kuna/museoncon/model/README.md

## Description

Those models only includes bottom parts and top parts. Other parts (body, scratch board) are reused from MuseOn controller.

### Original model URL
https://cad.onshape.com/documents/9d15ab35a640afc5610f11aa/w/20e474e34c52557906518db1/e/6f6ff2d6295136870e9082ac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
