kuna/museoncon/circuit/top.png

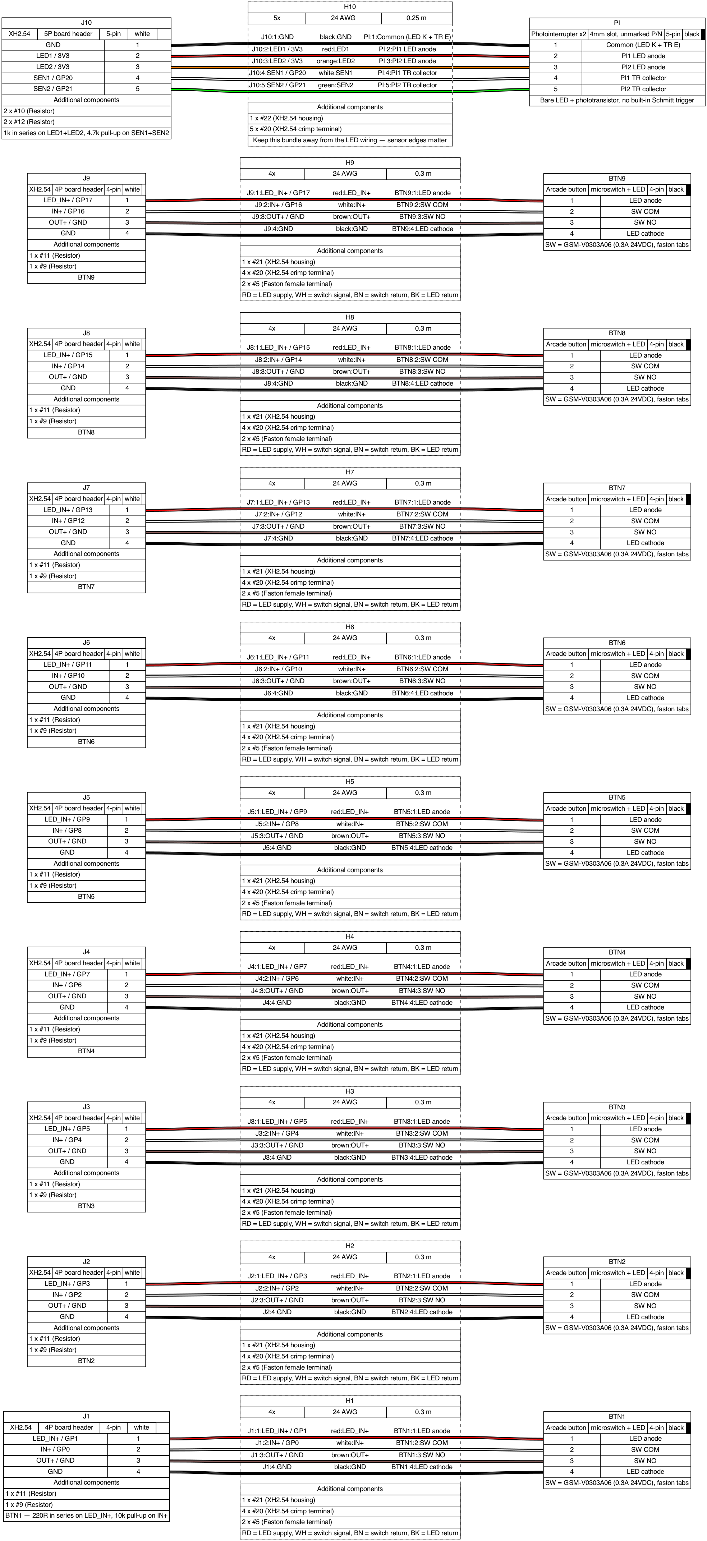
circuit/top.png
