kuna/museoncon/model/beatcon-btm-full.stl

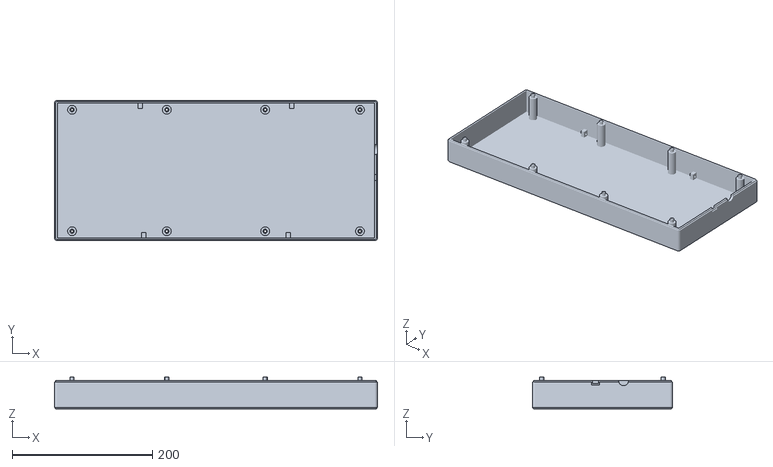
[picture p4: CAD file, 2026-10-25]
model/beatcon-btm-full.stl
460.0 x 200.0 x 45.0
