kuna/museoncon/model/beatcon-top.stl

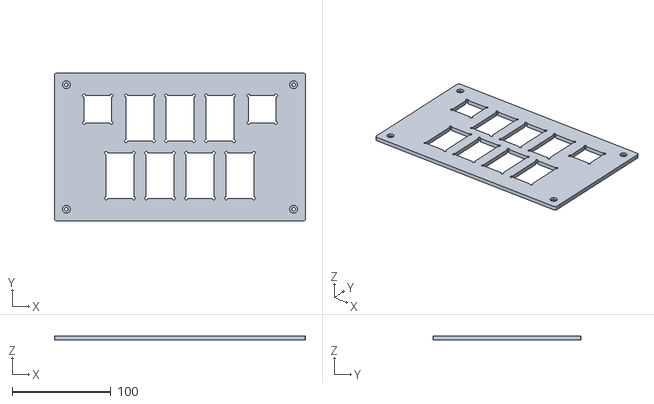
[picture p5: CAD file, 2026-10-25]
model/beatcon-top.stl
254.0 x 150.0 x 4.50
