kuna/museoncon/circuit/museon.kicad_pcb

## KiCad design circuit/museon.kicad_pcb (2026-10-25)

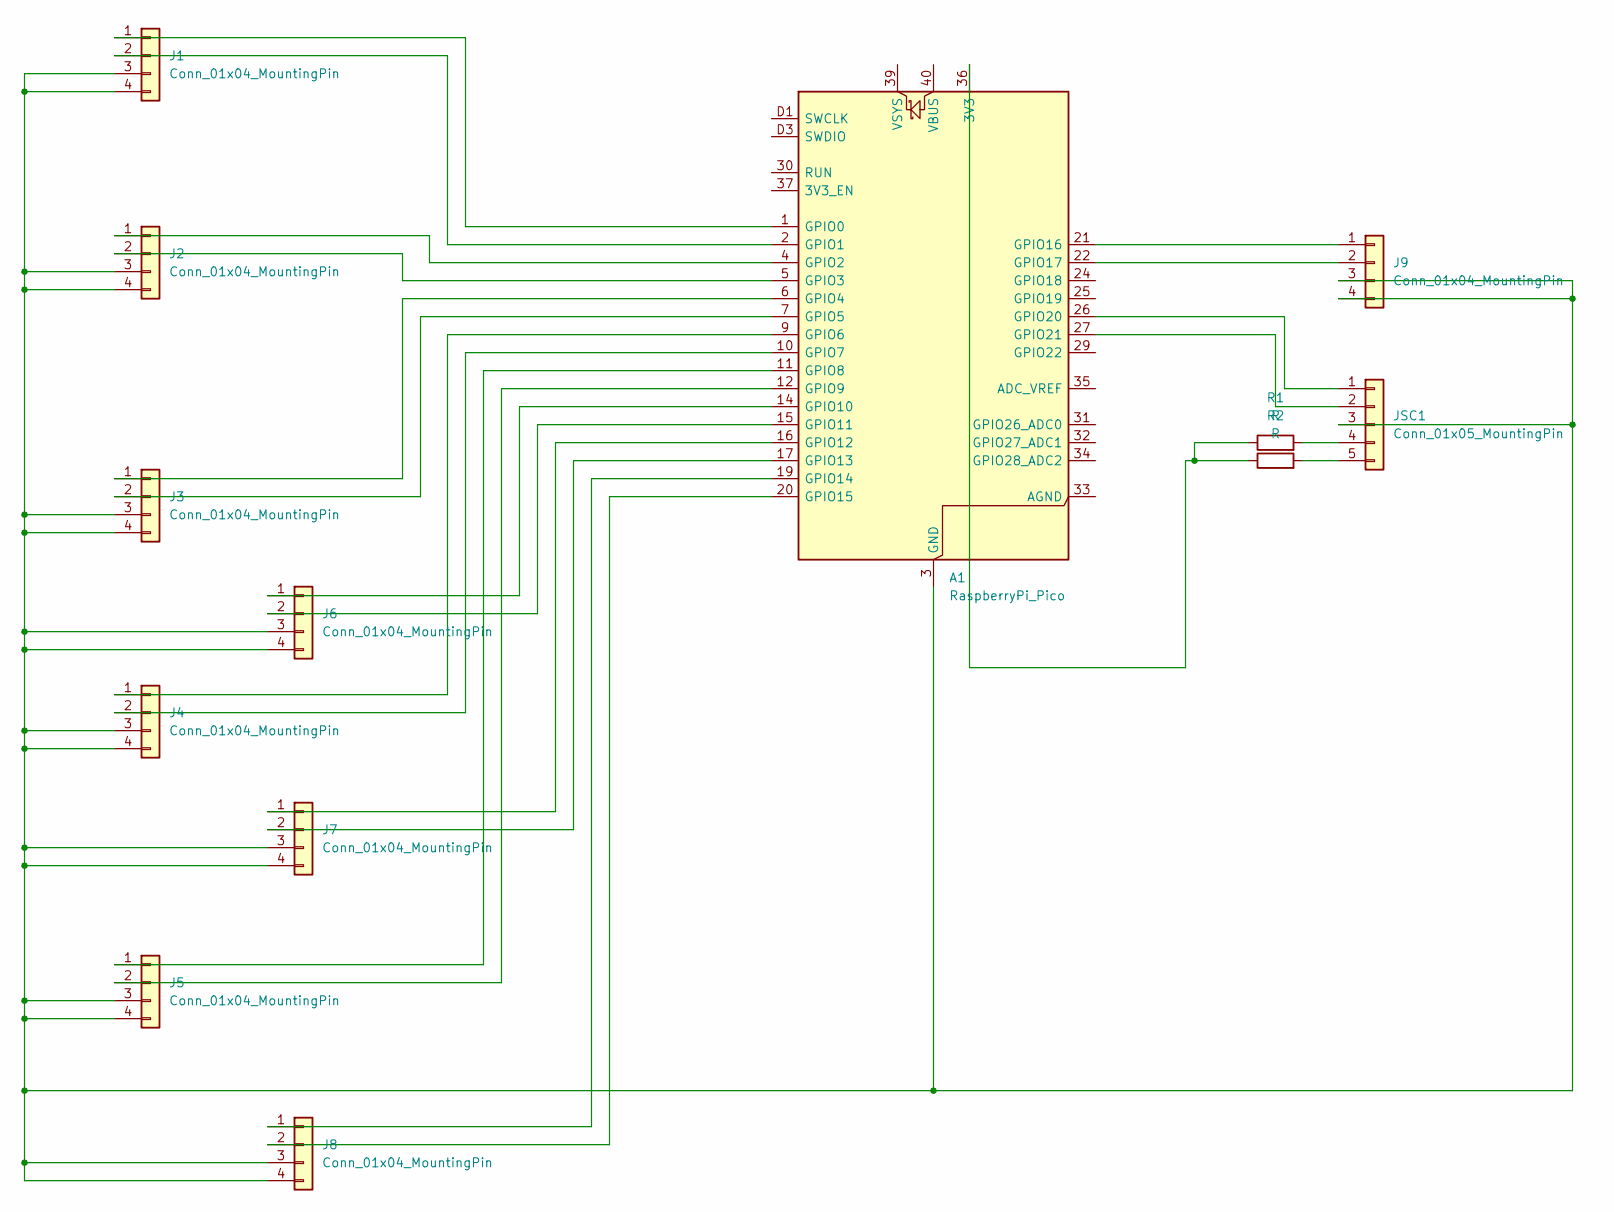
[picture p6: schematic museon.kicad_sch]

Parts:
A1: RaspberryPi_Pico; RaspberryPi_Pico_SMD_HandSolder
J1, J2, J3, J4, J5, J6, J7, J8, J9: Conn_01x04_MountingPin; JST_XH_B4B-XH-A_1x04_P2.50mm_Vertical
JSC1: Conn_01x05_MountingPin; JST_XH_B5B-XH-A_1x05_P2.50mm_Vertical
R1, R2: R; R_Axial_DIN0207_L6.3mm_D2.5mm_P7.62mm_Horizontal

Connections:
unnamed: A1.36 (3V3), R1.1, R2.1
unnamed: A1.1 (GPIO0), J1.1
unnamed: A1.2 (GPIO1), J1.2
unnamed: A1.4 (GPIO2), J2.1
unnamed: A1.5 (GPIO3), J2.2
unnamed: A1.6 (GPIO4), J3.1
unnamed: A1.7 (GPIO5), J3.2
unnamed: A1.9 (GPIO6), J4.1
unnamed: A1.10 (GPIO7), J4.2
unnamed: A1.11 (GPIO8), J5.1
unnamed: A1.12 (GPIO9), J5.2
unnamed: A1.14 (GPIO10), J6.1
unnamed: A1.15 (GPIO11), J6.2
unnamed: A1.16 (GPIO12), J7.1
unnamed: A1.17 (GPIO13), J7.2
unnamed: A1.19 (GPIO14), J8.1
unnamed: A1.20 (GPIO15), J8.2
unnamed: A1.21 (GPIO16), J9.1
unnamed: A1.22 (GPIO17), J9.2
unnamed: A1.26 (GPIO20), JSC1.1
unnamed: A1.27 (GPIO21), JSC1.2
unnamed: A1.3 (GND), A1.8 (GND), A1.13 (GND), A1.18 (GND), A1.23 (GND), A1.28 (GND), A1.38 (GND), A1.D2 (GND), J1.3, J1.4, J2.3, J2.4, J3.3, J3.4, J4.3, J4.4, J5.3, J5.4, J6.3, J6.4, J7.3, J7.4, J8.3, J8.4, J9.3, J9.4, JSC1.3
unnamed: JSC1.4, R1.2
unnamed: JSC1.5, R2.2

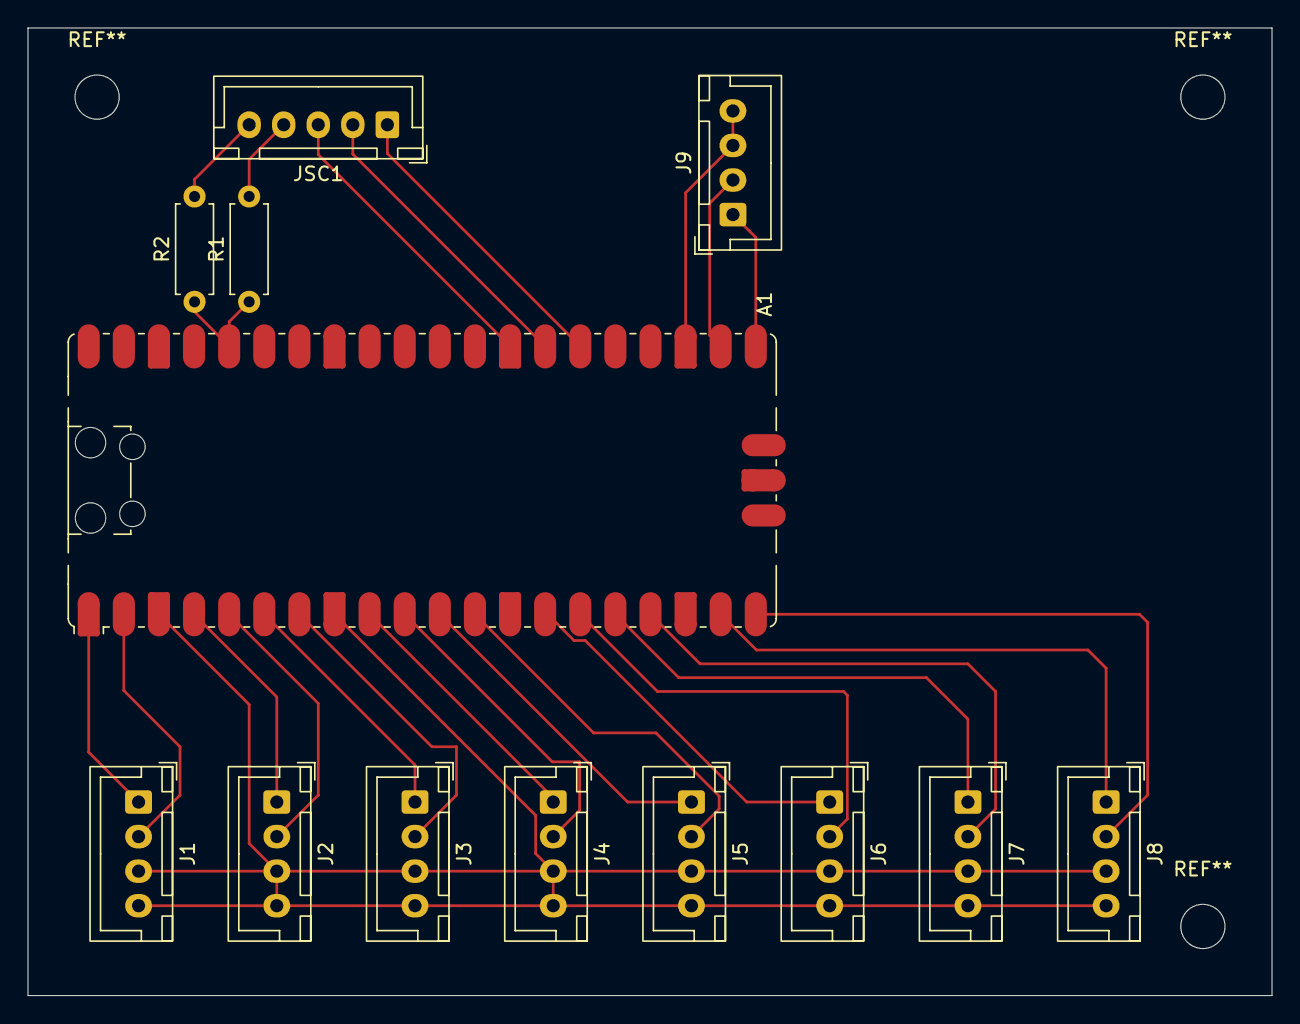
[picture p7: board museon.kicad_pcb from above]

Board: 2 copper layers, 90.0 x 70.0 mm, 13 parts (0 on the bottom side), 24 nets.
