kuna/museoncon/(commit log)

2026-10-11 Pair button and LED GPIOs for non-crossing routing
    - Each button's switch input and LED now sit on adjacent
    GPIOs (BTN1-8: GP0-GP15, BTN9: GP16/GP17) so their traces
    run side by side; GP15/GP16 are on opposite header rows
    and are never paired.
    - Move photointerrupter SEN1/SEN2 to GP20/GP21.
    - Update firmware pin map and free-pin notes to match.
    - Re-render the WireViz harness diagram.
2026-10-11 Add make build for the firmware (#2)
    - firmware/Makefile: `make build [MODE=...]` copies
    pico_sdk_import.cmake from $PICO_SDK_PATH, configures, and
    builds build/bitcon.uf2; `make clean` removes the build dir.
    - Point CMakeLists at the flat source layout; it referenced
    src/ and include/, which do not exist.
    - Define BOARD_TUD_RHPORT in tusb_config.h; pico-sdk does not,
    so main.c failed to compile.
    - Document macOS setup and make build in the README; ignore
    the build dir and the copied SDK import file.
    [tusb_config.h]
2026-10-20 Enable internal pull-ups on button and sensor inputs (#3)
    - Add USE_INTERNAL_PULLUP_BTN / USE_INTERNAL_PULLUP_SEN to
    config.h, both on by default, so the inputs read correctly
    even when the external 10k / 4.7k resistors are missing or
    a harness wire breaks.
    - gpio_setup() applies them to the button and photointerrupter
    pins; the external resistors remain the intended design.
    [config.h, main.c]
2026-10-21 Add a configurator page and a serial config port (#4)
    * Add a configurator page and a serial config port
    - Every mode now exposes a CDC serial port next to the HID
    interfaces. The output mode becomes a runtime setting stored
    in the last flash sector; changing it reboots the board so
    the host re-enumerates. GAMEPAD is the new default.
    - The port takes line commands (info, mode, stream, state,
    bootsel) and streams debounced and raw buttons, sensor levels,
    turntable position and invalid quadrature steps.
    - configurator/index.html is a self-contained Web Serial page
    for Chrome/Edge that shows live input and changes the mode.
    - bcdDevice bumped to 0x0200 for the new interface layout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
    [config.h, main.c, settings.c, settings.h, test_logic.c, tusb_config.h]
2026-10-25 Report the turntable on the gamepad Y axis (#5)
    - The turntable position now rides on Y; X is held at centre
    so DirectInput still sees a two-axis controller.
    - The report descriptor is unchanged; only which byte carries
    the value moved, so the USB layout and bcdDevice stay as-is.
    - Update the host test, configurator text, README and comments.
2026-10-25 Split the gamepad into LR2, beatoraja and INFINITAS modes (#6)
    Games read a turntable in incompatible ways, and the single gamepad
    mode's analog position axis broke scratch in LR2 and in beatoraja's
    default (analog scratch off) setup.
    - LR2: turntable on buttons 10/11. Digital logic registers after
    3.75 degrees and holds 200 ms after the last step (arcin's LR2
    setting); a reversal switches directly, never holding both.
    - beatoraja: digital X axis, 255 / 0 while spinning and centred when
    stopped, clearing beatoraja's +-0.9 threshold; 100 ms hold.
    - INFINITAS: analog X axis with the disc position, back on X like the
    official controller. 2 units per count so every count meets IIDX's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
    [config.h, main.c, settings.c, settings.h, test_logic.c]
2026-10-25 Update beatcon model (#8)
    [beatcon-btm-full.stl, beatcon-top.stl]
2026-10-25 Add PCB (#9)
    * Add Kicad PCB
    * Replace circuit preview to PCB screenshot
    [museon.kicad_pcb, museon.kicad_sch]
2026-10-27 Raise TT_DIGITAL_STEP to 3 to ignore reversal rebound (#10)
    * Raise TT_DIGITAL_STEP to 3 to ignore reversal rebound
    On fast back-and-forth scratches the disc rebounds slightly at each
    reversal, and at 2 counts (3.75 degrees) that rebound fired an extra
    scratch in beatoraja. 3 counts (5.6 degrees) rides it out.
    - Tests no longer assume a step of 2.
    - README recommends beatoraja's Input duration at about 25 ms, which
    tested more stable than the default 16 ms.
    * Keep README unchanged in the step change
    Revert the README edits from the previous commit; this branch only
    changes code.
    * Update README for TT_DIGITAL_STEP 3
    Match the step value in the turntable section and tuning table, with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
    [config.h, test_logic.c]
